N-Pulse/Custom-BioAmp-EXG-Pill/hardware/BioAmp-EXG-Pill.kicad_pcb

## KiCad design hardware/BioAmp-EXG-Pill.kicad_pcb (2025-03-15)

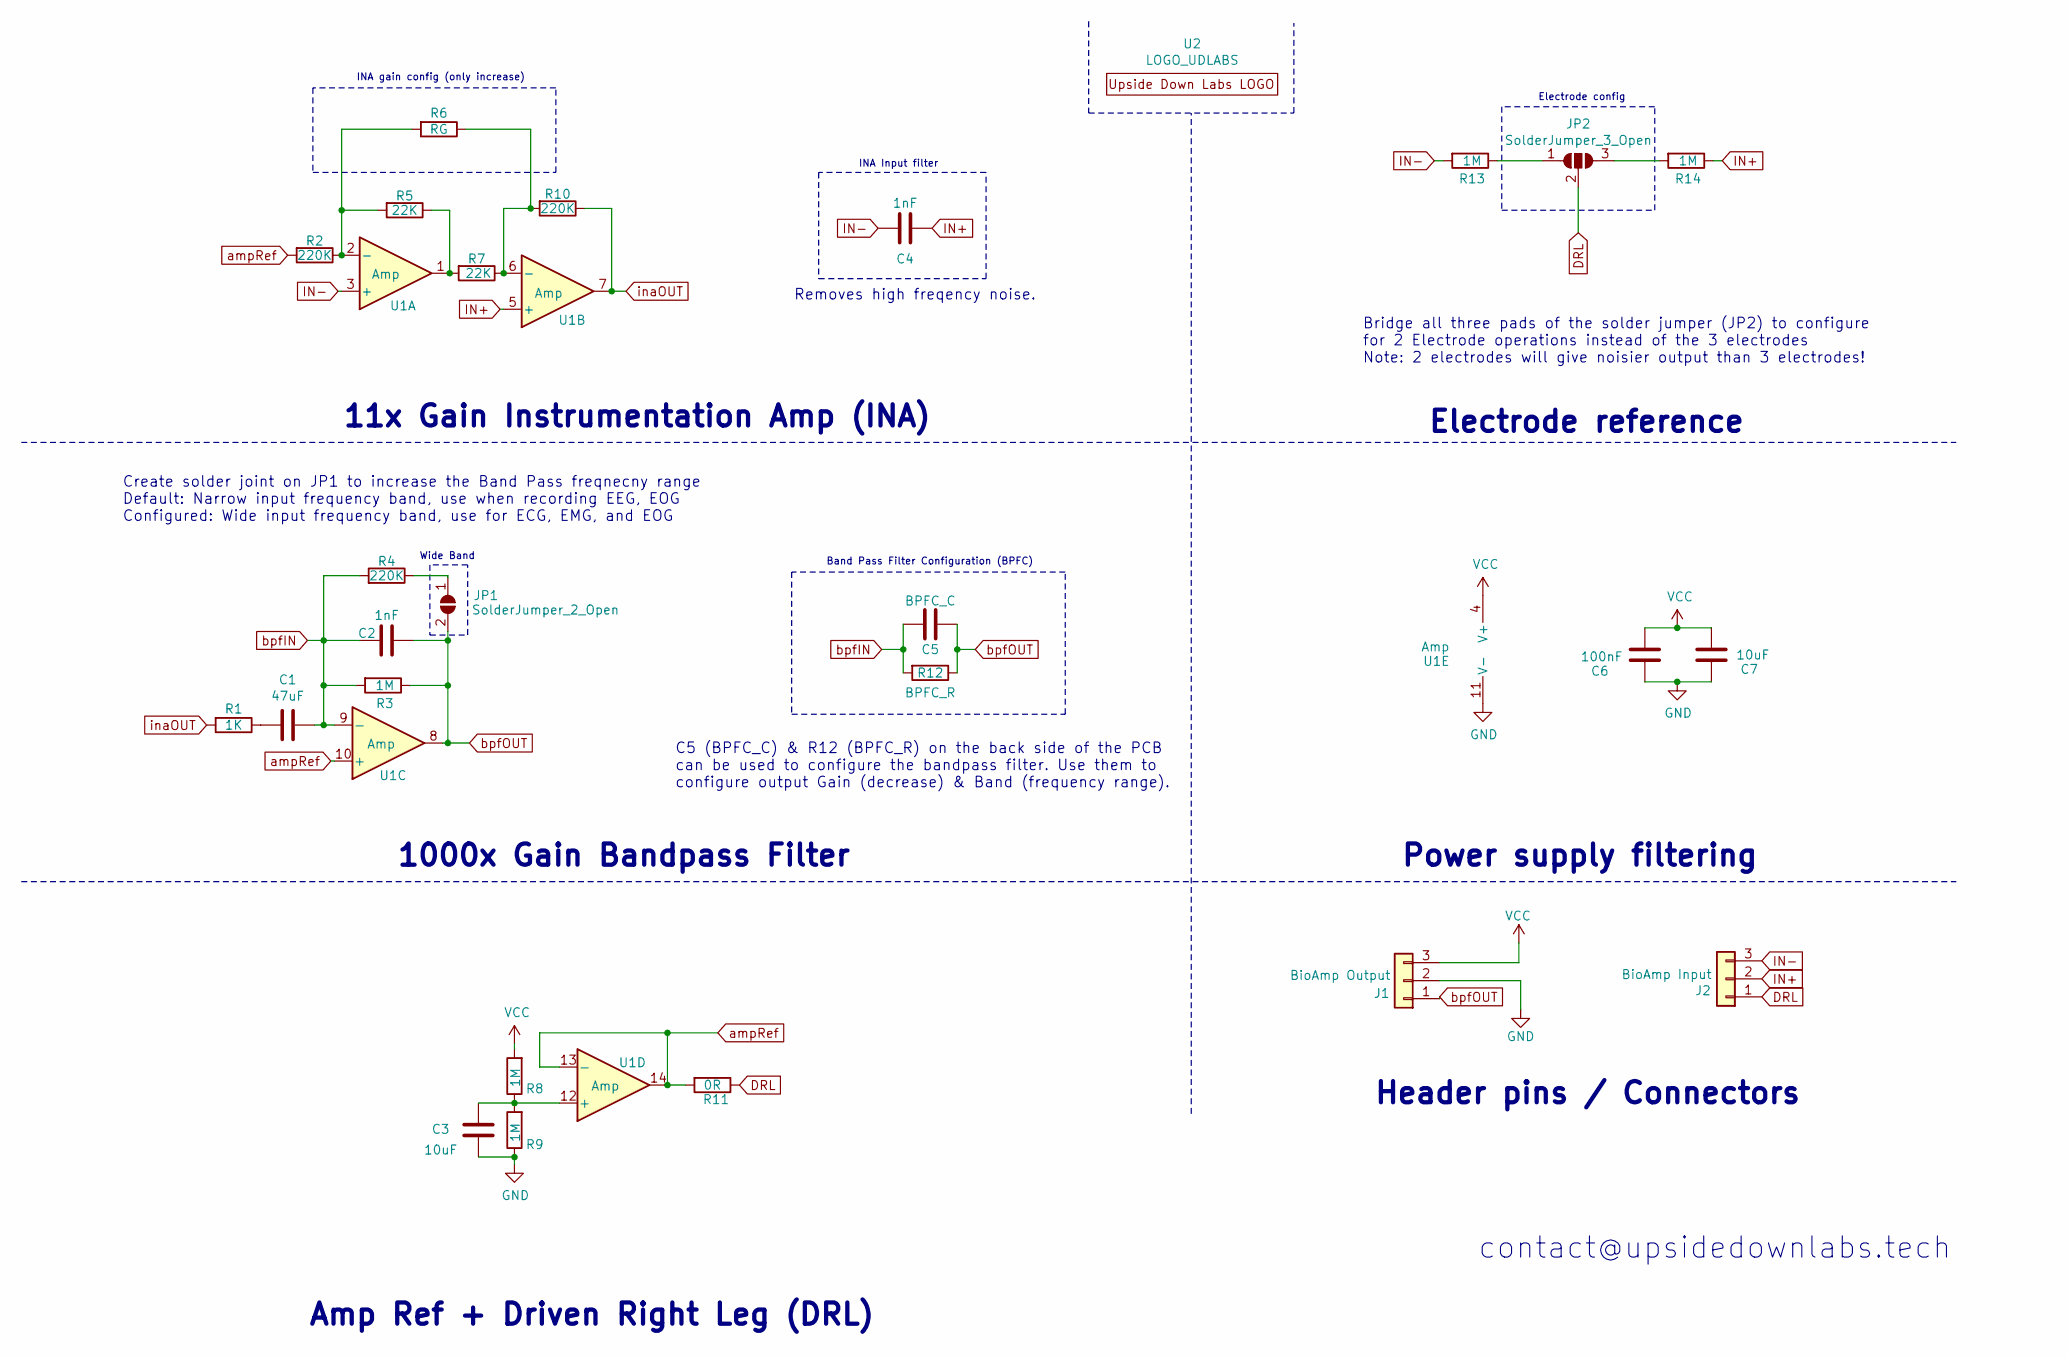
[picture p1: schematic BioAmp-EXG-Pill.kicad_sch, BioAmp EXG Pill]

Parts:
C1: 47uF; C_0805_2012Metric_Pad1.18x1.45mm_HandSolder
C2, C4: 1nF; C_0603_1608Metric_Pad1.08x0.95mm_HandSolder
C3, C7: 10uF; C_0603_1608Metric_Pad1.08x0.95mm_HandSolder
C5: BPFC_C; C_0603_1608Metric_Pad1.08x0.95mm_HandSolder
C6: 100nF; C_0603_1608Metric_Pad1.08x0.95mm_HandSolder
J1: BioAmp Output; PinHeader_1x03_P2.54mm_Vertical
J2: BioAmp Input; PinHeader_1x03_P2.54mm_Vertical
JP1: SolderJumper_2_Open; SolderJumper-2_P1.3mm_Open_RoundedPad1.0x1.5mm
JP2: SolderJumper_3_Open; SolderJumper-3_P1.3mm_Open_RoundedPad1.0x1.5mm
R1: 1K; R_0603_1608Metric_Pad0.98x0.95mm_HandSolder
R2, R4, R10: 220K; R_0603_1608Metric_Pad0.98x0.95mm_HandSolder
R3, R8, R9, R13, R14: 1M; R_0603_1608Metric_Pad0.98x0.95mm_HandSolder
R5, R7: 22K; R_0603_1608Metric_Pad0.98x0.95mm_HandSolder
R6: RG; R_0603_1608Metric_Pad0.98x0.95mm_HandSolder
R11: 0R; R_0603_1608Metric_Pad0.98x0.95mm_HandSolder
R12: BPFC_R; R_0603_1608Metric_Pad0.98x0.95mm_HandSolder
U1: Amp; TSSOP-14_4.4x5mm_P0.65mm
U2: LOGO_UDLABS; EXG

Connections:
DRL: J2.1, JP2.2 (C), R11.1; also elsewhere on the board
GND: C3.2, C6.1, C7.1, J1.2, R9.1, U1.11 (V-); also elsewhere on the board
IN+: C4.1, J2.2, R14.1, U1.5 (+); also elsewhere on the board
IN-: C4.2, J2.3, R13.2, U1.3 (+); also elsewhere on the board
unnamed: C1.2, R1.1
unnamed: C3.1, R8.1, R9.2, U1.12 (+)
unnamed: JP1.1 (A), R4.1
unnamed: JP2.1 (A), R13.1
unnamed: JP2.3 (B), R14.2
unnamed: R2.1, R5.2, R6.2, U1.2 (-)
unnamed: R5.1, R7.2, U1.1
unnamed: R6.1, R7.1, R10.2, U1.6 (-)
VCC: C6.2, C7.2, J1.3, R8.2, U1.4 (V+); also elsewhere on the board
ampRef: R2.2, R11.2, U1.10 (+), U1.13 (-), U1.14
bpfIN: C1.1, C2.2, C5.2, R3.2, R4.2, R12.2, U1.9 (-)
bpfOUT: C2.1, C5.1, J1.1, JP1.2 (B), R3.1, R12.1, U1.8; also elsewhere on the board
inaOUT: R1.2, R10.1, U1.7

Notes on the sheet:
contact@upsidedownlabs.tech
1000x Gain Bandpass Filter
Create solder joint on JP1 to increase the Band Pass freqnecny range Default: Narrow input frequency band, use when recording EEG, EOG Configured: Wide input frequency band, use for ECG, EMG, and EOG
Band Pass Filter Configuration (BPFC)
Electrode config
C5 (BPFC_C) & R12 (BPFC_R) on the back side of the PCB can be used to configure the bandpass filter. Use them to configure output Gain (decrease) & Band (frequency range).
Header pins / Connectors
11x Gain Instrumentation Amp (INA)
Bridge all three pads of the solder jumper (JP2) to configure for 2 Electrode operations instead of the 3 electrodes Note: 2 electrodes will give noisier output than 3 electrodes!
Power supply filtering
Amp Ref + Driven Right Leg (DRL)
Removes high freqency noise.
Wide Band
INA gain config (only increase)
Electrode reference
INA Input filter

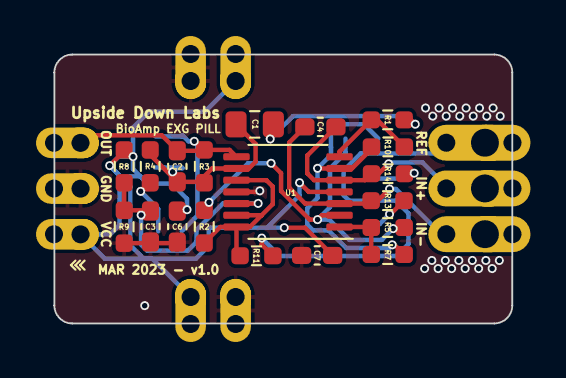
[picture p2: board BioAmp-EXG-Pill.kicad_pcb from above]

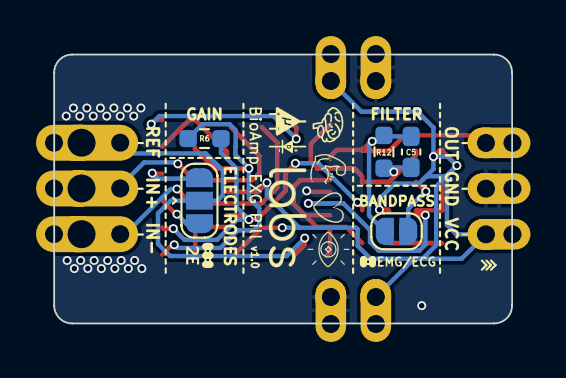
[picture p3: board BioAmp-EXG-Pill.kicad_pcb from below]

Board: 2 copper layers, 25.4 x 14.9 mm, 30 parts (6 on the bottom side), 17 nets.

Other parts of the board:
J1#2: BioAmp Output; PinHeader_1x03_P2.54mm_Vertical
J2#2, J2#3: BioAmp Input; PinHeader_1x03_P2.54mm_Vertical

Their connections:
DRL: J2#2.1, J2#3.1; also elsewhere on the board
GND: J1#2.2; also elsewhere on the board
IN+: J2#2.2, J2#3.2; also elsewhere on the board
IN-: J2#2.3, J2#3.3; also elsewhere on the board
VCC: J1#2.3; also elsewhere on the board
bpfOUT: J1#2.1; also elsewhere on the board
