N-Pulse/Custom-BioAmp-EXG-Pill/(commit log)

2025-03-08 add 2 power connectors for assembly in chain
    [BioAmp-EXG-Pill.kicad_pcb]
2025-03-15 add connectors and fill in ground
    [BioAmp-EXG-Pill.kicad_pcb]
2025-03-15 shrink the pcb's dimensions
    [BioAmp-EXG-Pill.kicad_pcb, BioAmp-EXG-Pill.kicad_sch]
